keshavshankar08/Arm-Sense/images/hardwareInside.jpeg

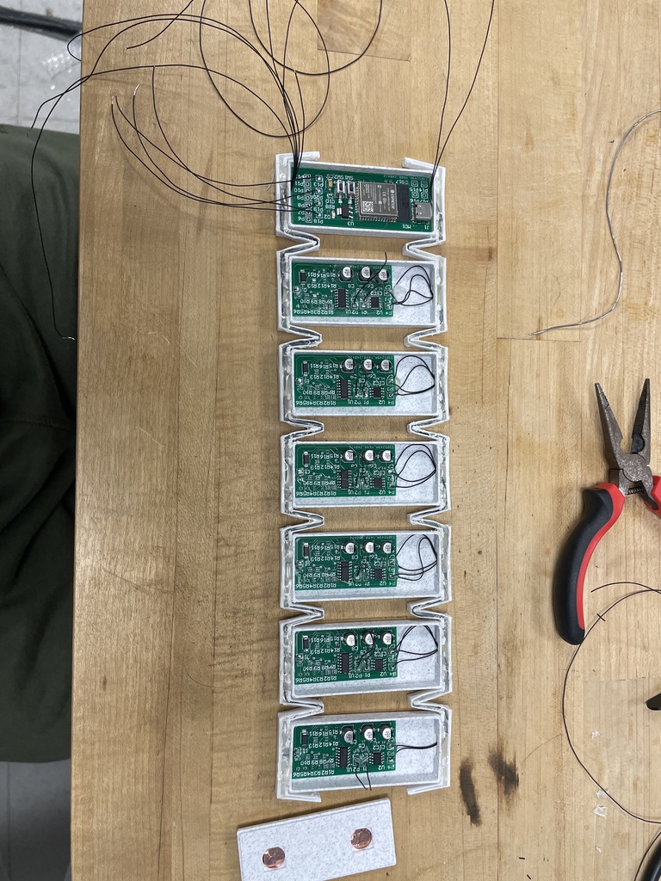
images/hardwareInside.jpeg
